r1b4z01d/OPNpool/hardware/OPNpool_r5/OPNpool_r5.kicad_sch

## KiCad design hardware/OPNpool_r5/OPNpool_r5.kicad_sch (2026-03-15)

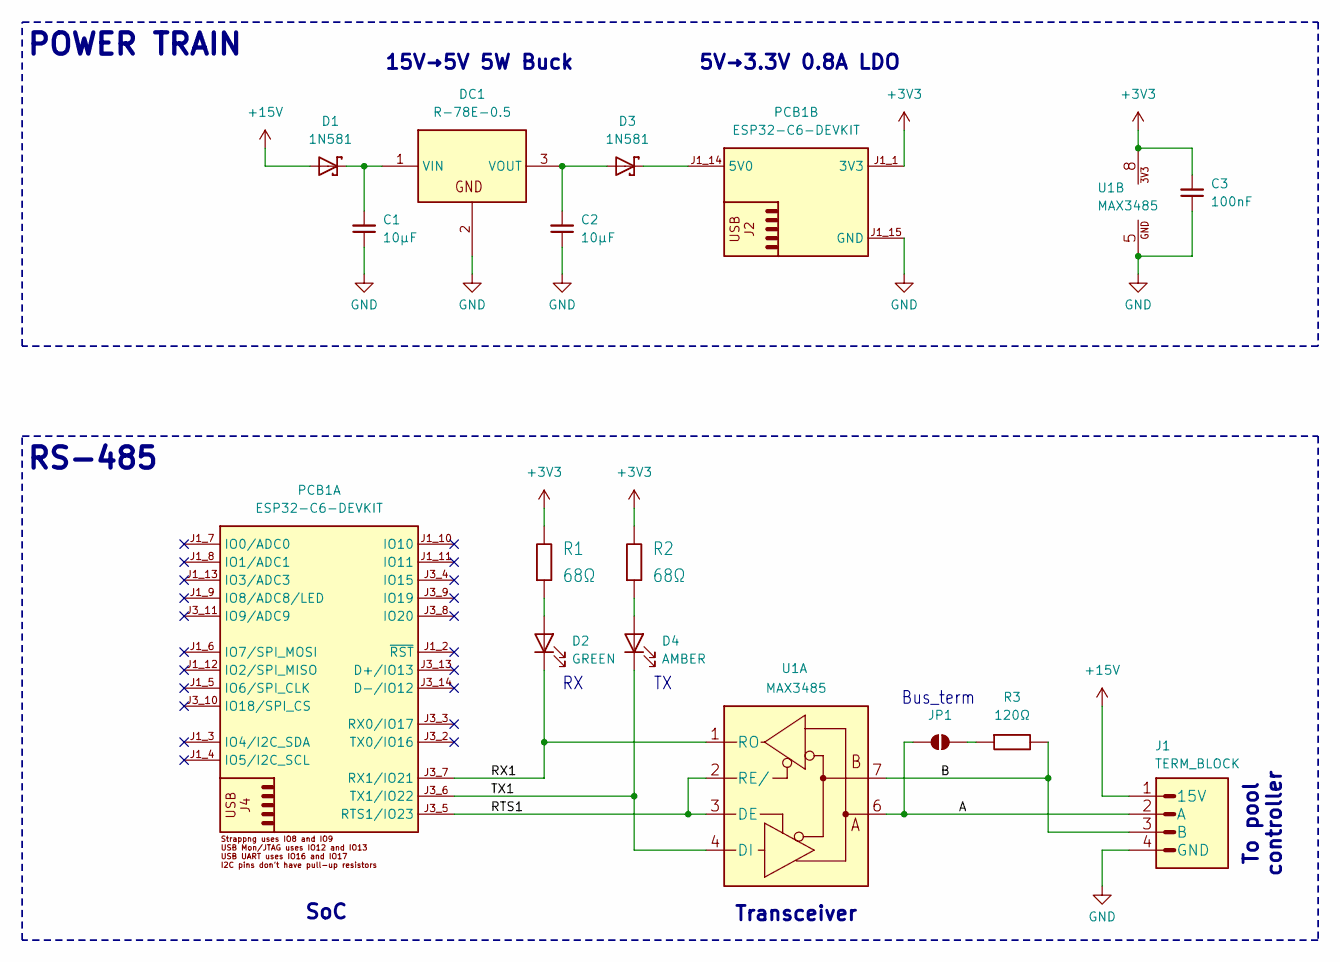
[picture p1: schematic OPNpool_r5.kicad_sch]

Parts:
C1, C2: 10μF; CAP CER 10µF 25V 0805
C3: 100nF; CAP CER 100nF 25V 0805
D1, D3: 1N581; DO41-DIO
D2: GREEN; LED-1206
D4: AMBER; LED-1206
DC1: R-78E-0.5; SIP3
J1: TERM_BLOCK; TERM BLOCK 4POS 45° 5mm PCB - CONN_1862437
JP1: SolderJumper_2_Open
PCB1: ESP32-C6-DEVKIT; EVAL ESP32-C6-DEVKITC
R1, R2: 68Ω; RES 68Ω 0805
R3: 120Ω; RES 120Ω 0805
U1: MAX3485; SO08

Connections:
+3V3: C3.2, PCB1.J1_1 (3V3), R1.2, R2.2, U1.8 (VCC)
+15V: D1.A, J1.1 (15V)
A: J1.2 (A), JP1.1 (A), U1.6 (A)
B: J1.3 (B), R3.2, U1.7 (B)
GND: C1.1, C2.1, C3.1, DC1.2 (GND), J1.4 (GND), PCB1.J1_15 (GND), PCB1.J3_1 (GND), PCB1.J3_12 (GND), PCB1.J3_15 (GND), U1.5 (GND)
unnamed: C1.2, D1.C, DC1.1 (VIN)
unnamed: C2.2, D3.A, DC1.3 (VOUT)
unnamed: D2.2 (A), R1.1
unnamed: D3.C, PCB1.J1_14 (5V0)
unnamed: D4.2 (A), R2.1
unnamed: JP1.2 (B), R3.1
RTS1: PCB1.J3_5 (RTS1/IO23), U1.2 (RE/), U1.3 (DE)
RX1: D2.1 (K), PCB1.J3_7 (RX1/IO21), U1.1 (RO)
TX1: D4.1 (K), PCB1.J3_6 (TX1/IO22), U1.4 (DI)

Notes on the sheet:
To pool controller
RS-485
POWER TRAIN
Transceiver
Bus_term
5V→3.3V 0.8A LDO
SoC
15V→5V 5W Buck
