r1b4z01d/OPNpool/components/opnpool/pool_task/network_create.cpp

/**
 * @file network_create.cpp
 * @brief Network layer: create datalink_pkt from network_msg
 *
 * @details
 * This file implements the logic for constructing datalink packets from higher-level
 * network messages within the OPNpool component. It provides functions to allocate
 * buffers, set protocol headers, and serialize network message data into the appropriate
 * datalink packet format for transmission over RS-485.
 *
 * ESPHome operates in a single-threaded environment, so explicit thread safety measures
 * are not required within the pool_task context.
 *
 * @author Coert Vonk (@cvonk on GitHub)
 * @copyright Copyright (c) 2014, 2019, 2022, 2026 Coert Vonk
 * @license SPDX-License-Identifier: GPL-3.0-or-later
 */

#include <esp_system.h>
#include <esp_types.h>
#include <string.h>
#include <esphome/core/log.h>

#include "utils/to_str.h"
#include "utils/enum_helpers.h"
#include "datalink.h"
#include "datalink_pkt.h"
#include "skb.h"
#include "network.h"
#include "network_msg.h"
#pragma GCC diagnostic error "-Wall"
#pragma GCC diagnostic error "-Wextra"
#pragma GCC diagnostic error "-Wunused-parameter"

namespace esphome {
namespace opnpool {

constexpr char TAG[] = "network_create";

/**
 * @brief Creates a datalink packet from a network message.
 *
 * Allocates a socket buffer, sets protocol headers based on message type, and copies
 * the message payload into the packet data area. The packet is ready for transmission
 * after this function returns successfully.
 *
 * @param[in]  msg Pointer to the network message to convert.
 * @param[out] pkt Pointer to the datalink packet structure to fill.
 * @return         ESP_OK on success, ESP_FAIL if message type is unknown or allocation fails.
 */
esp_err_t
network_create_pkt(network_msg_t const * const msg, datalink_pkt_t * const pkt)
{
    // get protocol info from the lookup table network_msg_typ_info[] in network_msg.h
    const network_msg_typ_info_t * info = network_msg_typ_get_info(msg->typ);
    if (info == nullptr) {
        ESP_LOGE(TAG, "unknown msg typ(%s)", enum_str(msg->typ));
        return ESP_FAIL;
    }

    uint32_t const data_len = info->size;

    pkt->src      = msg->src;
    pkt->dst      = msg->dst;
    pkt->prot     = info->proto;
    pkt->typ      = info->datalink_typ;
    pkt->ver      = 0x01;  // default; overridden by pool_task with learned controller version
    pkt->data_len = data_len;
    pkt->skb      = skb_alloc(DATALINK_MAX_HEAD_SIZE + data_len + DATALINK_MAX_TAIL_SIZE);
    if (!pkt->skb) {
        ESP_LOGW(TAG, "Failed to allocate socket buffer");
        return ESP_FAIL;
    }
    skb_reserve(pkt->skb, DATALINK_MAX_HEAD_SIZE);
    pkt->data = skb_put(pkt->skb, data_len);
    memcpy(pkt->data, msg->u.raw, data_len);
    return ESP_OK;
}

} // namespace opnpool
} // namespace esphome
