r1b4z01d/OPNpool/(commit log)

2026-03-15 rename pins
    [OPNpool_r5.kicad_sch]
2026-03-30 fixed unsupported ctrl_typ (72)
    [datalink.h, datalink_pkt.h, network_msg.h, poolstate_rx.cpp]
2026-04-07 Fixes set command
    Stamped outgoing A5 packets with the protocol version learned from the
    controller (0x31 for EasyTouch/SunTouch) instead of the hard-coded 0x01;
    the controller silently ignores SET commands with a mismatched version.
    Also switched the source address on CIRCUIT_SET and HEAT_SET to 0x22
    (ScreenLogic/wireless remote) to match what the controller expects.
    [datalink_pkt.h, datalink_rx.cpp, datalink_tx.cpp, network_create.cpp, pool_task.cpp]
2026-04-07 Temp Sensor fixes
    Fixed air/solar temperature mapping: air_temp was reading solar_temp_1 by
    mistake. Added solar as a distinct temperature type so all three sensors
    (air, water, solar) are published correctly.
    [opnpool-1.yaml, opnpool.cpp, opnpool.h, opnpool_ids.h, poolstate.h, poolstate_rx.cpp]
2026-04-07 Adds pump RPM control
    Adds a number entity (450-3450 RPM) that sends PUMP_REMOTE_CTRL_SET,
    PUMP_REG_VS_SET, and PUMP_RUN_SET to the IntelliFlo VS pump over RS-485.
    Confirmed speed is published back from PUMP_STATUS_RESP packets.
2026-04-10 Fix air temperature sensor and add solar temperature sensors
    - Fix air_temp using msg->air_temp instead of msg->solar_temp_1 which
    was always 0 on IntelliTouch controllers
    - Add SOLAR_1 and SOLAR_2 to poolstate_temp_typ_t enum
    - Add solar_temperature_1 and solar_temperature_2 analog sensors
    - Populate solar temps from msg->solar_temp_1 and msg->solar_temp_2
    - Expose solar sensors via ESPHome/Home Assistant
    Tested on Pentair IntelliTouch with ESP32-WROOM-32
    [opnpool.cpp, opnpool.h, poolstate.h, poolstate_rx.cpp]
2026-05-06 Fix "Broken at HEAD due to undefined SOLAR_TEMPERATURE_1" issue
    [opnpool-1.yaml, opnpool.cpp, opnpool.h, opnpool_ids.h]
2026-05-31 Decode IntelliChlor responses addressed to the controller (dst 0x00)
    Salt level, status, and name from the salt chlorine generator stopped
    appearing while the chlorination % kept working.
    The IC packet filter in network_rx_msg() only passed packets whose
    destination was broadcast (0x0F) or the chlorinator (0x50). The
    chlorinator's salt-bearing responses (MODEL_RESP 0x03, LEVEL_RESP 0x12)
    are addressed to the controller as dst 0x00 (ALL), so they were silently
    dropped. LEVEL_SET (0x11) survived only because it is sent TO the
    chlorinator (0x50), which is why the level kept updating.
    This was a regression: the original group-based check accepted the ALL
    group (which covered 0x00); a later ref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
2026-06-02 Schedule import and export
    Adds the EasyTouch detailed-schedule (SCHEDS) feature on top of the IntelliChlor
    work:
    - Parse SCHEDS_RESP into poolstate (circuit_plus_1, Sunday-first day bitmask).
    - SCHEDS_SET (0x91) write path + send_schedule(); verified on hardware (the
    controller replies CTRL_SET_ACK{SCHEDS_SET}).
    - Home Assistant services export_schedules / import_schedule(yaml) (require
    custom_services + homeassistant_services in api:).
    - Request all 12 schedule slots once at startup (TX queue 5->16) so export sees
    the full set within seconds; rotate one slot per cycle thereafter.
